tunelipt/espmcpdaq/README.md

# espmcpdaq
Simple data acquisition system using ESP32 and MCP3208
