tunelipt/espmcpdaq/mcp3208x4/mcp3208x4.kicad_pcb

## KiCad design mcp3208x4/mcp3208x4.kicad_pcb (2024-12-16)

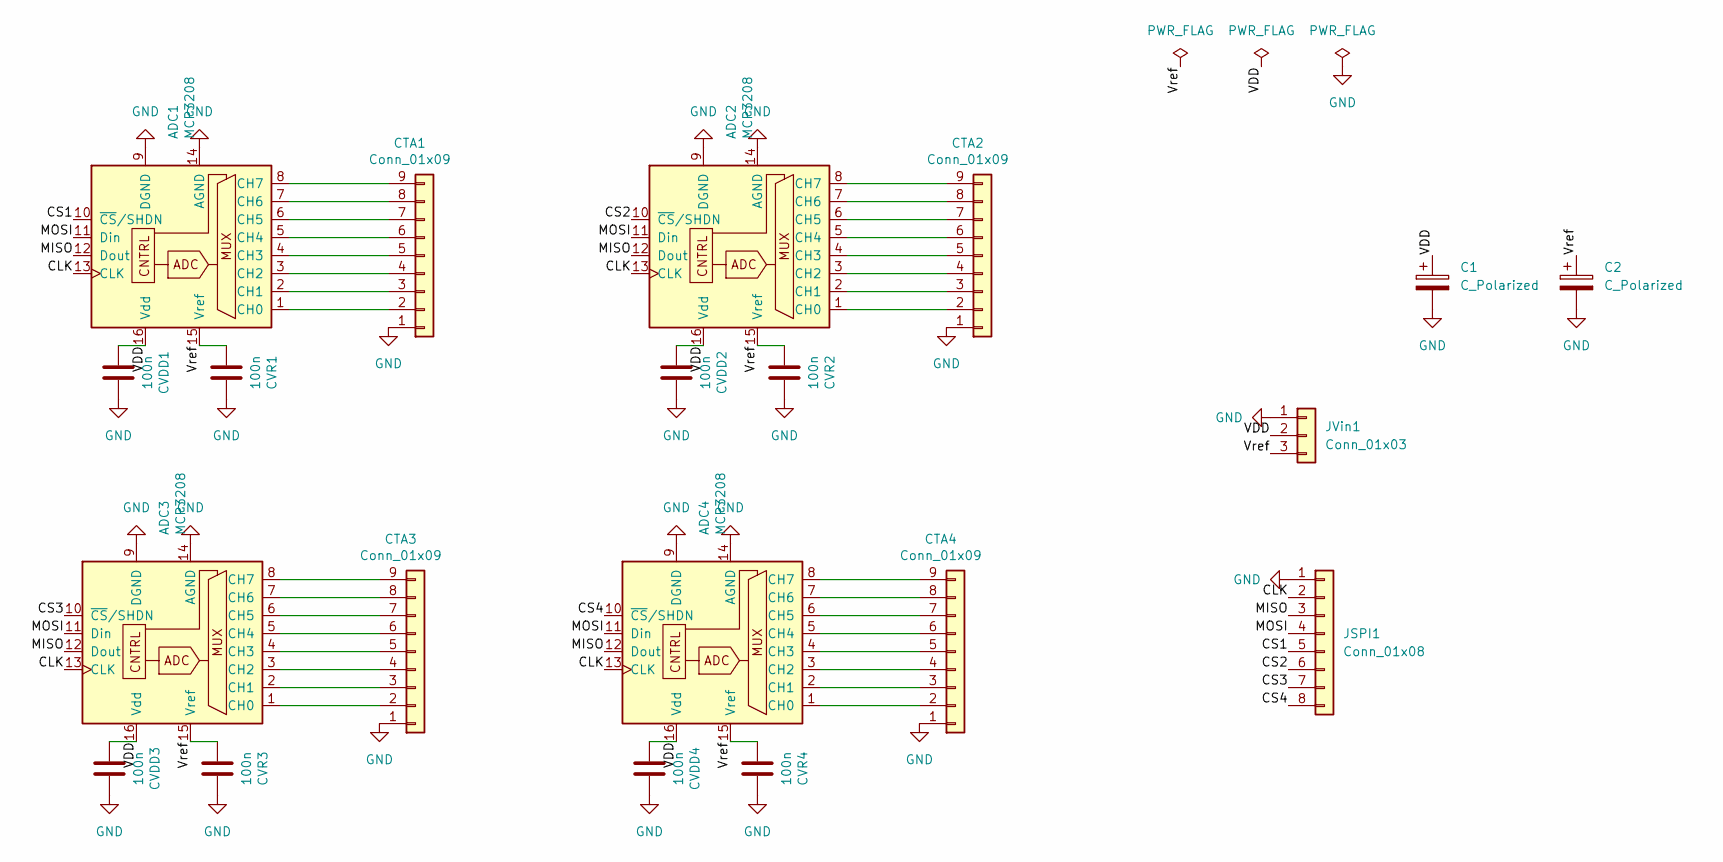
[picture p1: schematic mcp3208x4.kicad_sch]

Parts:
ADC1, ADC2, ADC3, ADC4: MCP3208; DIP-16_W7.62mm_LongPads
C1, C2: C_Polarized; CP_Radial_D5.0mm_P2.50mm
CTA1, CTA2, CTA3, CTA4: Conn_01x09; PinHeader_1x09_P2.54mm_Vertical
CVDD1, CVDD2, CVDD3, CVDD4: 100n; C_Rect_L7.2mm_W3.0mm_P5.00mm_FKS2_FKP2_MKS2_MKP2
CVR1, CVR2, CVR3, CVR4: 100n; C_Rect_L7.2mm_W3.0mm_P5.00mm_FKS2_FKP2_MKS2_MKP2
JSPI1: Conn_01x08; PinHeader_1x08_P2.54mm_Horizontal
JVin1: Conn_01x03; PinHeader_1x03_P2.54mm_Horizontal

Connections:
/CLK: ADC1.13 (CLK), ADC2.13 (CLK), ADC3.13 (CLK), ADC4.13 (CLK), JSPI1.2
/CS1: ADC1.10 (~CS/SHDN), JSPI1.5
/CS2: ADC2.10 (~CS/SHDN), JSPI1.6
/CS3: ADC3.10 (~CS/SHDN), JSPI1.7
/CS4: ADC4.10 (~CS/SHDN), JSPI1.8
/MISO: ADC1.12 (Dout), ADC2.12 (Dout), ADC3.12 (Dout), ADC4.12 (Dout), JSPI1.3
/MOSI: ADC1.11 (Din), ADC2.11 (Din), ADC3.11 (Din), ADC4.11 (Din), JSPI1.4
/VDD: ADC1.16 (Vdd), ADC2.16 (Vdd), ADC3.16 (Vdd), ADC4.16 (Vdd), C1.1, CVDD1.2, CVDD2.2, CVDD3.2, CVDD4.2, JVin1.2
/Vref: ADC1.15 (Vref), ADC2.15 (Vref), ADC3.15 (Vref), ADC4.15 (Vref), C2.1, CVR1.2, CVR2.2, CVR3.2, CVR4.2, JVin1.3
GND: ADC1.9 (DGND), ADC1.14 (AGND), ADC2.9 (DGND), ADC2.14 (AGND), ADC3.9 (DGND), ADC3.14 (AGND), ADC4.9 (DGND), ADC4.14 (AGND), C1.2, C2.2, CTA1.1, CTA2.1, CTA3.1, CTA4.1, CVDD1.1, CVDD2.1, CVDD3.1, CVDD4.1, CVR1.1, CVR2.1, CVR3.1, CVR4.1, JSPI1.1, JVin1.1
unnamed: ADC1.1 (CH0), CTA1.2
unnamed: ADC1.2 (CH1), CTA1.3
unnamed: ADC1.3 (CH2), CTA1.4
unnamed: ADC1.4 (CH3), CTA1.5
unnamed: ADC1.5 (CH4), CTA1.6
unnamed: ADC1.6 (CH5), CTA1.7
unnamed: ADC1.7 (CH6), CTA1.8
unnamed: ADC1.8 (CH7), CTA1.9
unnamed: ADC2.1 (CH0), CTA2.2
unnamed: ADC2.2 (CH1), CTA2.3
unnamed: ADC2.3 (CH2), CTA2.4
unnamed: ADC2.4 (CH3), CTA2.5
unnamed: ADC2.5 (CH4), CTA2.6
unnamed: ADC2.6 (CH5), CTA2.7
unnamed: ADC2.7 (CH6), CTA2.8
unnamed: ADC2.8 (CH7), CTA2.9
unnamed: ADC3.1 (CH0), CTA3.2
unnamed: ADC3.2 (CH1), CTA3.3
unnamed: ADC3.3 (CH2), CTA3.4
unnamed: ADC3.4 (CH3), CTA3.5
unnamed: ADC3.5 (CH4), CTA3.6
unnamed: ADC3.6 (CH5), CTA3.7
unnamed: ADC3.7 (CH6), CTA3.8
unnamed: ADC3.8 (CH7), CTA3.9
unnamed: ADC4.1 (CH0), CTA4.2
unnamed: ADC4.2 (CH1), CTA4.3
unnamed: ADC4.3 (CH2), CTA4.4
unnamed: ADC4.4 (CH3), CTA4.5
unnamed: ADC4.5 (CH4), CTA4.6
unnamed: ADC4.6 (CH5), CTA4.7
unnamed: ADC4.7 (CH6), CTA4.8
unnamed: ADC4.8 (CH7), CTA4.9

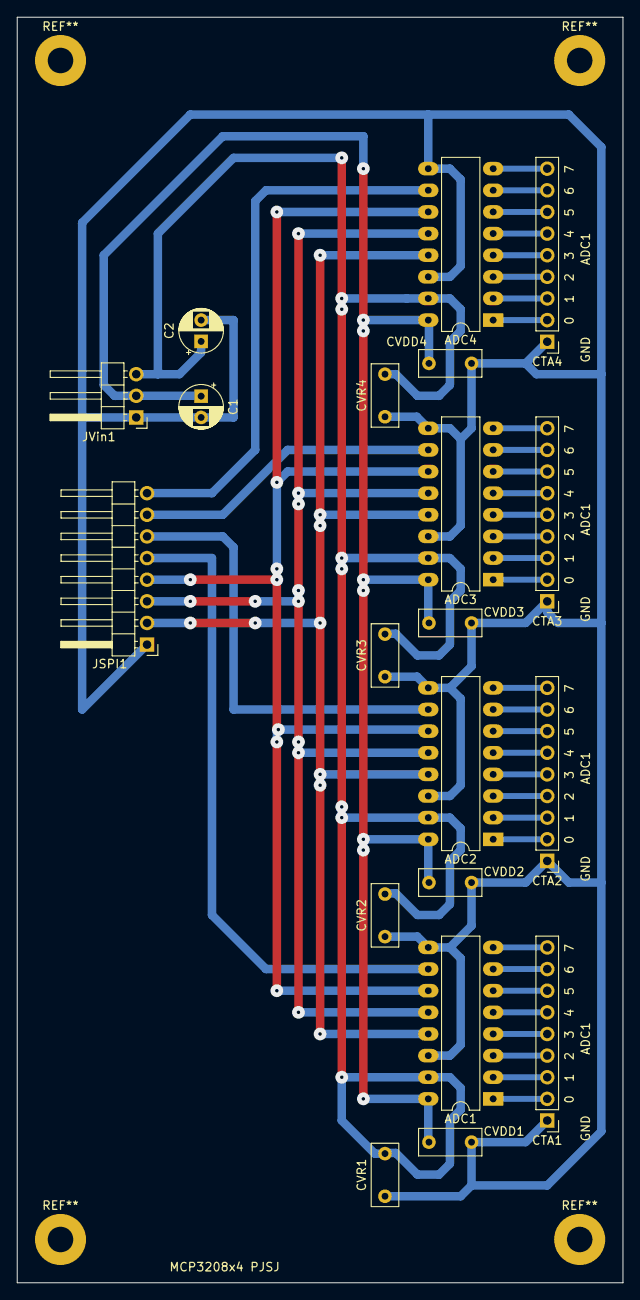
[picture p2: board mcp3208x4.kicad_pcb from above]

Board: 2 copper layers, 71.1 x 148.6 mm, 20 parts (0 on the bottom side), 42 nets.
