tunelipt/espmcpdaq/(commit log)

2022-06-14 Initial commit of espmcpdaq
    This is very simple ADC board developed using ESP32 and MCP3208.
    Up to 4 MCPs can be used with a total of 32 single ended channels.
    It uses LM336-2.5V as a reference voltage for ADC. This repository
    also contains the arduino files for the ESP and a python interface,
    server and client.
    [espmcpdaq.kicad_pcb, espmcpdaq.sch]
2024-11-05 Trying to update to KiCad 8 and changing the board size
    The board should have the same size as the multianem8 board
    There are several issues with pin compatibility. I should check this
    out later...
    [espmcpdaq.kicad_pcb, espmcpdaq.kicad_sch]
2024-11-06 Corrected hte ERC problems.
    The issues kind of make sense. Since the same MISO and MOSI are used for every ADC, the system complains about connecting different outputs together. This not an issue because each ADC has different chip select wire. There were several warnings about unspecified pins connected to some other pins. I just asked KiCAD to ignore this
    I still need to think about power supply for the board. The anemometers will use 24V and I could reduce this to 5V using a 78-5 or LM317 but they will run hot due to the large voltage drop. Another thing I should think about is how adding a button to select voltage source: USB or power supply. I think I will rearrange everything and add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
    [espmcpdaq.kicad_pcb, espmcpdaq.kicad_sch]
2024-11-07 Added the possibility of choosing 5V input.
    The 5V input can come from either a terminal or the esp board USB.
    I've been thinking and I believe I should make the daq part independent
    of the board. Therefore I should deal only with SPI lines and input voltage.
    [espmcpdaq.kicad_pcb, espmcpdaq.kicad_sch]
2024-11-09 Just added a little text
    [espmcpdaq.kicad_pcb]
2024-12-16 Created a board without without microcontroller or voltage reference.
    Now we can use with any microcontroller os SBC. And I can test different voltage references other than LM336.
    [mcp3208x4.kicad_pcb, mcp3208x4.kicad_sch, mcp3208x4.sch]
2026-06-08 COnverted the code to PlatformIO
    I think this is easier/better than the Arduino IDE.
2026-06-09 Corrected bug when doing async daq
    [espmcpdaq.py]
2026-06-12 Started to simplify the python code
    I was getting some crashes. I think I will change the approach.
    [espmcpdaq.py]
